tomrodinger/thread_border_router/README.md

# thread_border_router
This is an implementation of a low cost Matter / Thread Border Router to bridge from Ethernet to 802.15.4
