tomrodinger/thread_border_router/Border Router.kicad_pcb

## KiCad design Border Router.kicad_pcb (2023-03-02)

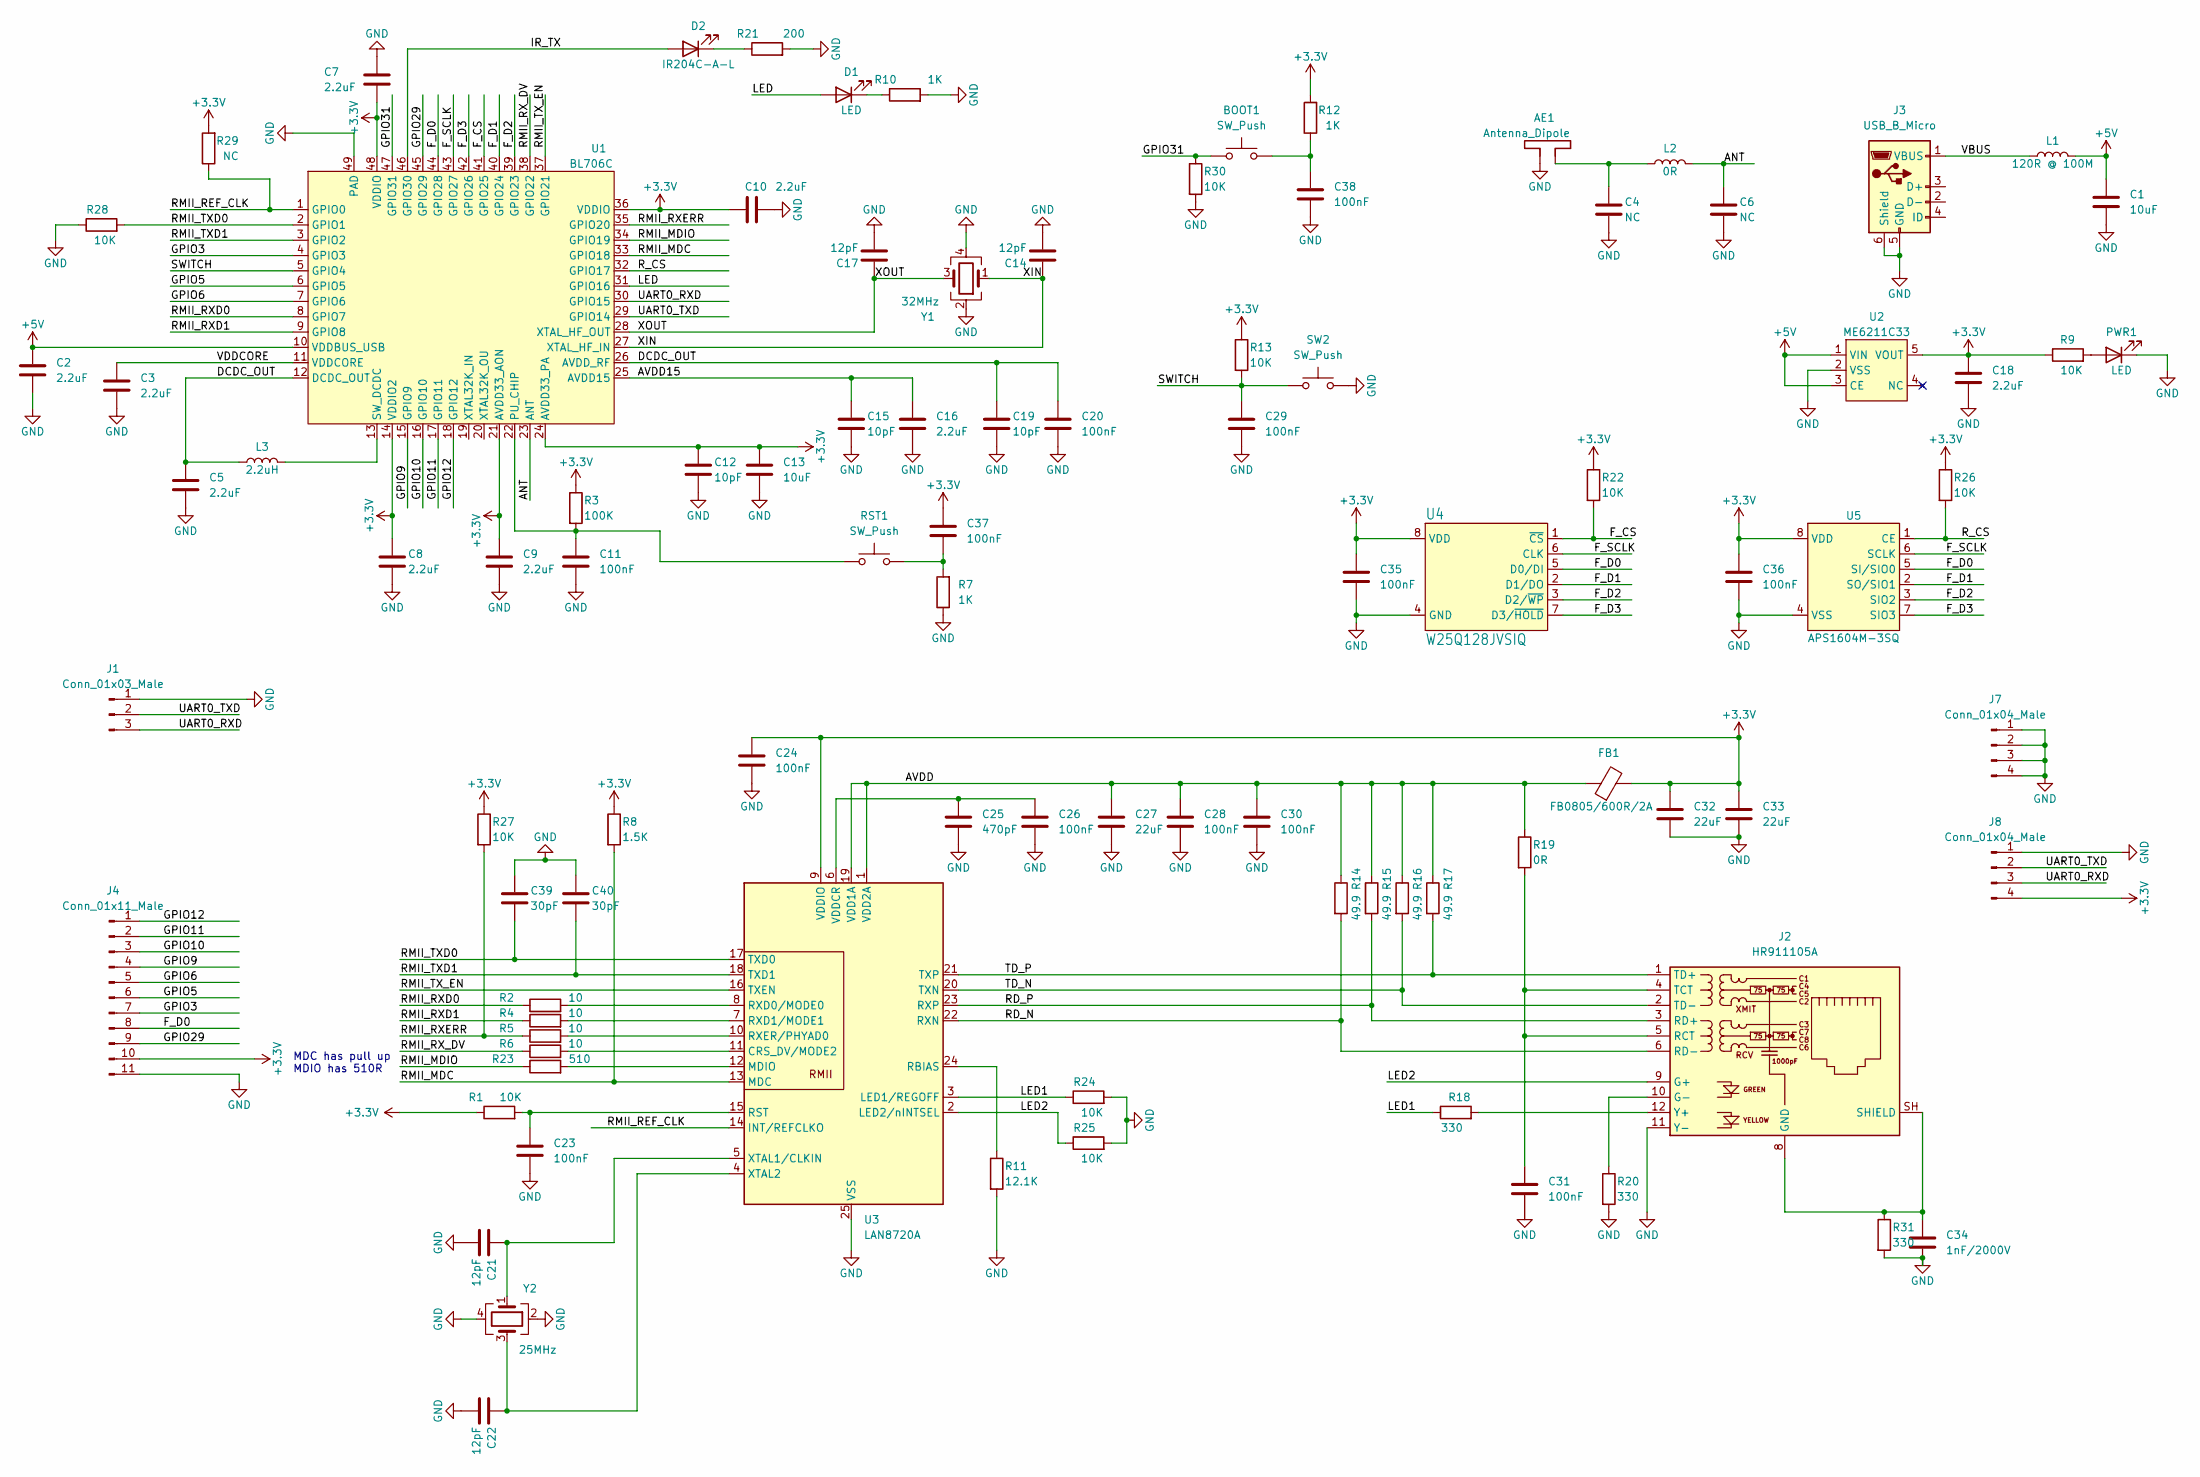
[picture p1: schematic Border Router.kicad_sch]

Parts:
AE1: Antenna_Dipole; Texas_SWRA117D_2.4GHz_Right
BOOT1: SW_Push; SW_SPST_EVQPE1; LCSC PN C720477
C1, C13: 10uF; C_0603_1608Metric; LCSC PN C96446
C2, C3, C5, C7, C8, C9, C10, C16, C18: 2.2uF; C_0402_1005Metric; LCSC PN C12530
C4, C6: NC; C_0402_1005Metric
C11, C20, C23, C24, C26, C28, C29, C30, C31, C35, C36, C37, C38: 100nF; C_0402_1005Metric; LCSC PN C307331
C12, C15, C19: 10pF; C_0402_1005Metric; LCSC PN C32949
C14, C21: 12pF; C_0402_1005Metric; LCSC PN C1547
C17, C22: 12pF; C_0402_1005Metric
C25: 470pF; C_0402_1005Metric
C27, C32, C33: 22uF; C_0805_2012Metric
C34: 1nF/2000V; C_1206_3216Metric
C39, C40: 30pF; C_0402_1005Metric
D1: LED; LED_0603_1608Metric; LCSC PN C434420
D2: IR204C-A-L; LED_D3.0mm_Horizontal_O3.81mm_Z2.0mm; LCSC PN C98863
FB1: FB0805/600R/2A; L_0805_2012Metric; LCSC C304329
J1: Conn_01x03_Male; PinHeader_1x03_P2.54mm_Vertical
J2: HR911105A; LCSC C12074
J3: USB_B_Micro; USB_Micro-B_Molex-105017-0001; LCSC C962222
J4: Conn_01x11_Male; PinSocket_1x11_P2.54mm_Vertical
J7, J8: Conn_01x04_Male; PinHeader_1x04_P2.54mm_Vertical
L1: 120R @ 100M; L_0603_1608Metric; LCSC PN C42102
L2: 0R; L_0402_1005Metric
L3: 2.2uH; L_0805_2012Metric; LCSC PN C86089
PWR1: LED; LED_0603_1608Metric; LCSC PN C434420
R1, R9, R13, R22, R24, R25, R26, R27, R28, R30: 10K; R_0402_1005Metric; LCSC PN C25744
R2, R4, R5, R6: 10; R_0402_1005Metric
R3: 100K; R_0402_1005Metric; LCSC PN C25744
R7, R10, R12: 1K; R_0402_1005Metric; LCSC PN C11702
R8: 1.5K; R_0402_1005Metric
R11: 12.1K; R_0402_1005Metric
R14, R15, R16, R17: 49.9; R_0402_1005Metric
R18: 330; R_0402_1005Metric
R19: 0R; R_0402_1005Metric
R20, R31: 330; R_0402_1005Metric; LCSC PN C25123
R21: 200; R_0402_1005Metric
R23: 510; R_0402_1005Metric
R29: NC; R_0402_1005Metric
RST1: SW_Push; SW_SPST_EVQPE1; LCSC PN C720477
SW2: SW_Push; SW_SPST_EVQPE1; LCSC PN C720477
U1: BL706C; QFN-48-1EP_6x6mm_P0.4mm_EP4.3x4.3mm
U2: ME6211C33; SOT-23-5; LCSC PN C82942
U3: LAN8720A; QFN-24-1EP_4x4mm_P0.5mm_EP2.6x2.6mm; LCSC C45223
U4: W25Q128JVSIQ; SOIC-8_5.275x5.275mm_P1.27mm; LCSC C97521
U5: APS1604M-3SQ; SOP-8_3.9x4.9mm_P1.27mm
Y1: 32MHz; Crystal_SMD_2016-4Pin_2.0x1.6mm; LCSC PN C255896
Y2: 25MHz; Crystal_SMD_3225-4Pin_3.2x2.5mm; LCSC PN C9006

Connections:
+3V3: C7.2, C8.1, C9.1, C10.2, C12.1, C13.1, C18.1, C24.1, C32.1, C33.1, C35.1, C36.1, C37.1, FB1.2, J4.10, J8.4, R1.1, R3.1, R8.1, R9.1, R12.2, R13.1, R22.1, R26.1, R27.1, R29.2, U1.14 (VDDIO2), U1.21 (AVDD33_AON), U1.24 (AVDD33_PA), U1.36 (VDDIO), U1.48 (VDDIO), U2.5 (VOUT), U3.9 (VDDIO), U4.8 (VDD), U5.8 (VDD)
+5V: C1.1, C2.1, L1.2, U1.10 (VDDBUS_USB), U2.1 (VIN), U2.3 (CE)
/ANT: C6.1, L2.2, U1.23 (ANT)
/AVDD: C27.1, C28.1, C30.1, FB1.1, R14.1, R15.1, R16.1, R17.1, R19.1, U3.1 (VDD2A), U3.19 (VDD1A)
/AVDD15: C15.1, C16.1, U1.25 (AVDD15)
/DCDC_OUT: C5.1, C19.1, C20.1, L3.1, U1.12 (DCDC_OUT), U1.26 (AVDD_RF)
/F_CS: R22.2, U1.41 (GPIO25), U4.1 (~CS)
/F_D0: J4.8, U1.44 (GPIO28), U4.5 (D0/DI), U5.5 (SI/SIO0)
/F_D1: U1.40 (GPIO24), U4.2 (D1/DO), U5.2 (SO/SIO1)
/F_D2: U1.39 (GPIO23), U4.3 (D2/~WP), U5.3 (SIO2)
/F_D3: U1.42 (GPIO26), U4.7 (D3/~HOLD), U5.7 (SIO3)
/F_SCLK: U1.43 (GPIO27), U4.6 (CLK), U5.6 (SCLK)
/GPIO3: J4.7, U1.4 (GPIO3)
/GPIO5: J4.6, U1.6 (GPIO5)
/GPIO6: J4.5, U1.7 (GPIO6)
/GPIO9: J4.4, U1.15 (GPIO9)
/GPIO10: J4.3, U1.16 (GPIO10)
/GPIO11: J4.2, U1.17 (GPIO11)
/GPIO12: J4.1, U1.18 (GPIO12)
/GPIO29: J4.9, U1.45 (GPIO29)
/GPIO31: BOOT1.1, R30.1, U1.47 (GPIO31)
/IR_TX: D2.2 (A), U1.46 (GPIO30)
/LED: D1.2 (A), U1.31 (GPIO16)
/LED1: R18.1, R24.1, U3.3 (LED1/REGOFF)
/LED2: J2.9 (G+), R25.1, U3.2 (LED2/nINTSEL)
/RD_N: J2.6 (RD-), R14.2, U3.22 (RXN)
/RD_P: J2.3 (RD+), R15.2, U3.23 (RXP)
/RMII_MDC: R8.2, U1.33 (GPIO18), U3.13 (MDC)
/RMII_MDIO: R23.1, U1.34 (GPIO19)
/RMII_REF_CLK: R29.1, U1.1 (GPIO0), U3.14 (INT/REFCLKO)
/RMII_RXD0: R2.1, U1.8 (GPIO7)
/RMII_RXD1: R4.1, U1.9 (GPIO8)
/RMII_RXERR: R5.1, R27.2, U1.35 (GPIO20)
/RMII_RX_DV: R6.1, U1.38 (GPIO22)
/RMII_TXD0: C39.2, R28.2, U1.2 (GPIO1), U3.17 (TXD0)
/RMII_TXD1: C40.2, U1.3 (GPIO2), U3.18 (TXD1)
/RMII_TX_EN: U1.37 (GPIO21), U3.16 (TXEN)
/R_CS: R26.2, U1.32 (GPIO17), U5.1 (CE)
/SWITCH: C29.1, R13.2, SW2.1, U1.5 (GPIO4)
/TD_N: J2.2 (TD-), R16.2, U3.20 (TXN)
/TD_P: J2.1 (TD+), R17.2, U3.21 (TXP)
/UART0_RXD: J1.3, J8.3, U1.30 (GPIO15)
/UART0_TXD: J1.2, J8.2, U1.29 (GPIO14)
/VBUS: J3.1 (VBUS), L1.1
/VDDCORE: C3.1, U1.11 (VDDCORE)
/XIN: C14.1, U1.27 (XTAL_HF_IN), Y1.1
/XOUT: C17.1, U1.28 (XTAL_HF_OUT), Y1.3
GND: AE1.2, C1.2, C2.2, C3.2, C4.2, C5.2, C6.2, C7.1, C8.2, C9.2, C10.1, C11.2, C12.2, C13.2, C14.2, C15.2, C16.2, C17.2, C18.2, C19.2, C20.2, C21.2, C22.2, C23.2, C24.2, C25.2, C26.2, C27.2, C28.2, C29.2, C30.2, C31.2, C32.2, C33.2, C34.2, C35.2, C36.2, C38.2, C39.1, C40.1, J1.1, J2.11 (Y-), J3.5 (GND), J3.6 (Shield), J4.11, J7.1, J7.2, J7.3, J7.4, J8.1, PWR1.1 (K), R7.1, R10.2, R11.2, R20.2, R21.2, R24.2, R25.2, R28.1, R30.2, R31.2, SW2.2, U1.49 (PAD), U2.2 (VSS), U3.25 (VSS), U4.4 (GND), U5.4 (VSS), Y1.2, Y1.4, Y2.2, Y2.4
unnamed: AE1.1, C4.1, L2.1
unnamed: BOOT1.2, C38.1, R12.1
unnamed: C11.1, R3.2, RST1.1, U1.22 (PU_CHIP)
unnamed: C21.1, U3.5 (XTAL1/CLKIN), Y2.1
unnamed: C22.1, U3.4 (XTAL2), Y2.3
unnamed: C23.1, R1.2, U3.15 (RST)
unnamed: C25.1, C26.1, U3.6 (VDDCR)
unnamed: C31.1, J2.4 (TCT), J2.5 (RCT), R19.2
unnamed: C34.1, J2.8 (GND), J2.SH (SHIELD), R31.1
unnamed: C37.2, R7.2, RST1.2
unnamed: D1.1 (K), R10.1
unnamed: D2.1 (K), R21.1
unnamed: J2.10 (G-), R20.1
unnamed: J2.12 (Y+), R18.2
unnamed: L3.2, U1.13 (SW_DCDC)
unnamed: PWR1.2 (A), R9.2
unnamed: R2.2, U3.8 (RXD0/MODE0)
unnamed: R4.2, U3.7 (RXD1/MODE1)
unnamed: R5.2, U3.10 (RXER/PHYAD0)
unnamed: R6.2, U3.11 (CRS_DV/MODE2)
unnamed: R11.1, U3.24 (RBIAS)
unnamed: R23.2, U3.12 (MDIO)

Notes on the sheet:
MDC has pull up MDIO has 510R

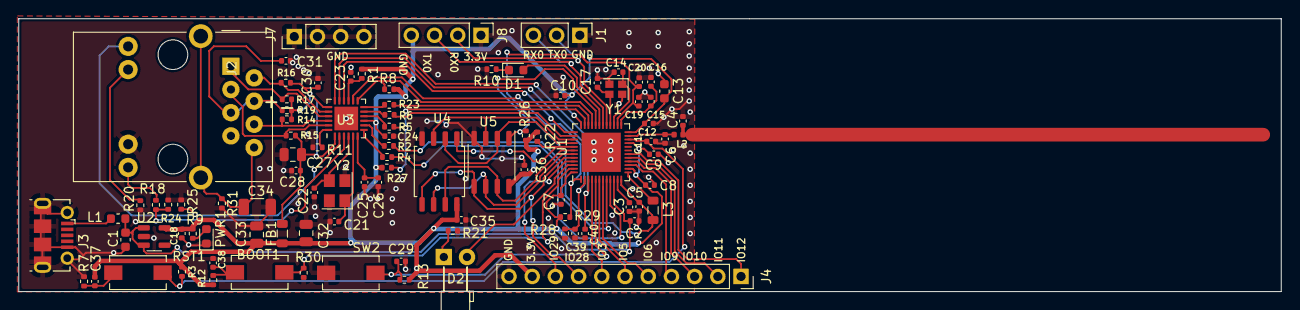
[picture p2: board Border Router.kicad_pcb from above]

Board: 2 copper layers, 138.2 x 29.9 mm, 94 parts (0 on the bottom side), 70 nets.
